domgregori/huBulb/esp8266-fastled-mqtt.ino

/*
   huBulb: https://github.com/domgregori/huBulb
   ESP8266 + FastLED + MQTT: https://github.com/jasoncoon/esp8266-fastled-webserver
   Copyright (C) 2015 Jason Coon

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
   You should have received a copy of the GNU General Public License
   along with this program.  If not, see <http://www.gnu.org/licenses/>.
*/


// TODO Flickering LED's ... https://github.com/FastLED/FastLED/issues/394 or https://github.com/FastLED/FastLED/issues/306
#define FASTLED_ALLOW_INTERRUPTS 0
#define FASTLED_ESP8266_RAW_PIN_ORDER
//#define FASTLED_INTERRUPT_RETRY_COUNT 0
#include "FastLED.h"
FASTLED_USING_NAMESPACE

extern "C" {
#include "user_interface.h"
}

#include <ESP8266WiFi.h>
#include <WiFiClient.h>
#include <EEPROM.h>
#include <PubSubClient.h>
#include <ArduinoJson.h>
#include "GradientPalettes.h"
#include "Settings.h"

CRGB leds[NUM_LEDS];

uint8_t patternIndex = 0;

const uint8_t brightnessCount = 5;
uint8_t brightnessMap[brightnessCount] = { 16, 32, 64, 128, 255 };
int brightnessIndex = 0;
uint8_t brightness = brightnessMap[brightnessIndex];

#define ARRAY_SIZE(A) (sizeof(A) / sizeof((A)[0]))

// ten seconds per color palette makes a good demo
// 20-120 is better for deployment
#define SECONDS_PER_PALETTE 10

///////////////////////////////////////////////////////////////////////

// Forward declarations of an array of cpt-city gradient palettes, and
// a count of how many there are.  The actual color palette definitions
// are at the bottom of this file.
extern const TProgmemRGBGradientPalettePtr gGradientPalettes[];
extern const uint8_t gGradientPaletteCount;

// Current palette number from the 'playlist' of color palettes
uint8_t gCurrentPaletteNumber = 0;

CRGBPalette16 gCurrentPalette( CRGB::Black);
CRGBPalette16 gTargetPalette( gGradientPalettes[0] );

uint8_t currentPatternIndex = 0; // Index number of which pattern is current
bool autoplayEnabled = false;

uint8_t autoPlayDurationSeconds = 10;
unsigned int autoPlayTimeout = 0;

uint8_t gHue = 0; // rotating "base color" used by many of the patterns

CRGB solidColor = CRGB::Black;

uint8_t power = 1;

// Mqtt Vars
WiFiClient espClient;
PubSubClient client(espClient);


typedef void (*Pattern)();
typedef Pattern PatternList[];
typedef struct {
  Pattern pattern;
  String name;
} PatternAndName;
typedef PatternAndName PatternAndNameList[];
// List of patterns to cycle through.  Each is defined as a separate function below.

#include "PatternLogics.h"

PatternAndNameList patterns = {
  { colorwaves, "Color Waves" },
  { palettetest, "Palette Test" },
  { pride, "Pride" },
  { rainbow, "Rainbow" },
  { rainbowWithGlitter, "Rainbow With Glitter" },
  { confetti, "Confetti" },
  { sinelon, "Sinelon" },
  { juggle, "Juggle" },
  { bpm, "BPM" },
  { fire, "Fire" },
  { showSolidColor, "Solid Color" },
};
const uint8_t patternCount = ARRAY_SIZE(patterns);

#include "Inits.h"

int powerFlag = 100;
int patternFlag = 100;
int brightnessFlag = 300;
int colorFlag[3] = {0,0,0};
int timer = millis();

void setup(void) {
  Serial.begin(115200);
  delay(100);
  //Serial.setDebugOutput(true);
  EEPROM.begin(512);
  loadSettings();
  initFastLED();

  logSys();

  initWlan();
  

  // Only to validate certs if u have problems ...
  // verifytls();

  //Mqtt Init
  client.setServer(mqtt_server, mqtt_port);
  client.setCallback(callback);
  autoPlayTimeout = millis() + (autoPlayDurationSeconds * 1000);
}


void callback(char* topic, byte* payload, unsigned int length) {
  char tmp[length + 1];
  strncpy(tmp, (char*)payload, length);
  tmp[length] = '\0';
  String data(tmp);

  Serial.printf("Received Data from Topic: %s ", topic);
  Serial.print(data);
  Serial.println();
  if (data.length() > 0){
    if (strcmp(topic,"huBulb/power")==0) {
      if (data == "on"){
        setPower(1);
      } else if (data == "off") {
        setPower(0);
      }
            
    } else if (strcmp(topic,"huBulb/brightness")==0) {
      setBrightness(data.toInt());
      
    } else if (strcmp(topic,"huBulb/effect")==0) {
      setPattern(data.toInt());
      
    } else if (strcmp(topic,"huBulb/color")==0) {
      String r =  getValue(data, ',', 0);
      String g =  getValue(data, ',', 1);
      String b =  getValue(data, ',', 2);
      if (r.length() > 0 && g.length() > 0 && b.length() > 0) {
        setSolidColor(r.toInt(), g.toInt(), b.toInt());
      }
    }
  }

  
}

void loop(void) {
  yield(); // Avoid crashes on ESP8266
  // Add entropy to random number generator; we use a lot of it.
  random16_add_entropy(random(65535));
  if (!client.connected()) {
    reconnectMqtt();
  }
  client.loop();



  if (power == 0) {
    fill_solid(leds, NUM_LEDS, CRGB::Black);
    FastLED.show();
    delay(15);
    return;
  }


  EVERY_N_MILLISECONDS( 20 ) {
    gHue++;  // slowly cycle the "base color" through the rainbow
  }

  // change to a new cpt-city gradient palette
  EVERY_N_SECONDS( SECONDS_PER_PALETTE ) {
    gCurrentPaletteNumber = addmod8( gCurrentPaletteNumber, 1, gGradientPaletteCount);
    gTargetPalette = gGradientPalettes[ gCurrentPaletteNumber ];
  }

  // slowly blend the current cpt-city gradient palette to the next
  EVERY_N_MILLISECONDS(40) {
    nblendPaletteTowardPalette( gCurrentPalette, gTargetPalette, 16);
  }

  if (autoplayEnabled && millis() > autoPlayTimeout) {
    adjustPattern(true);
    autoPlayTimeout = millis() + (autoPlayDurationSeconds * 1000);
  }

  // Call the current pattern function once, updating the 'leds' array
  patterns[currentPatternIndex].pattern();

  FastLED.show();
  
  if ((powerFlag != EEPROM.read(5)) || (brightnessFlag != EEPROM.read(0)) || (patternFlag != EEPROM.read(1)) || (colorFlag[0] != EEPROM.read(2)) || (colorFlag[1] != EEPROM.read(3)) || (colorFlag[2] != EEPROM.read(4)) || (millis() - timer >= 5000)) {
    StaticJsonDocument<200> jsonBuffer;
    JsonObject json = jsonBuffer.to<JsonObject>();
    json["status"] = "online";
    if (EEPROM.read(5) == 1) {
      json["power"] = "on";
    } else {
      json["power"] = "off";
    }    
    json["brightness"] = EEPROM.read(0);
    json["pattern"] = EEPROM.read(1);
    JsonArray colorJ = json.createNestedArray("color");
    json["color"].add(EEPROM.read(2));
    json["color"].add(EEPROM.read(3));
    json["color"].add(EEPROM.read(4));
    char buff[200];
    serializeJson(json, buff);

    Serial.println(buff);
    
    if (client.publish("huBulb/status", buff, true) == false) {
      Serial.println("Error publishing status");
    }

    json.clear();

    powerFlag = EEPROM.read(5);
    brightnessFlag = EEPROM.read(0);
    patternFlag = EEPROM.read(1);
    colorFlag[0] = EEPROM.read(2);
    colorFlag[1] = EEPROM.read(3);
    colorFlag[2] = EEPROM.read(4);
    timer = millis();
  }
  

  // insert a delay to keep the framerate modest
  delay(1000 / FRAMES_PER_SECOND);
}


void reconnectMqtt() {
  while (!client.connected()) {
    Serial.println("Attempting MQTT connection...");
    if (client.connect(mqtt_clientid, mqtt_user, mqtt_password, "huBulb/status", 1, 0, "{\"status\":\"offline\"}")) {
      Serial.println("connected");
      client.subscribe("huBulb/power");
      client.subscribe("huBulb/brightness");
      client.subscribe("huBulb/effect");
      client.subscribe("huBulb/color");
    } else {
      Serial.print("failed, rc=");
      Serial.print(client.state());
      Serial.println(" try again in 5 seconds");
      // Wait 5 seconds before retrying
      delay(5000);
    }
  }
}


void setPower(uint8_t value)
{
  power = value == 0 ? 0 : 1;
  if (power == 0) {
    Serial.println("{\"power\":\"off\"}");
    if (client.publish("huBulb/status", "{\"power\":\"off\"}", true) == false) {
      Serial.println("Error publishing power");
    }
  }
  EEPROM.write(5, power);
  EEPROM.commit();
  
}

void setSolidColor(CRGB color)
{
  setSolidColor(color.r, color.g, color.b);
}

void setSolidColor(uint8_t r, uint8_t g, uint8_t b)
{
  solidColor = CRGB(r, g, b);

  EEPROM.write(2, r);
  EEPROM.write(3, g);
  EEPROM.write(4, b);

  setPattern(patternCount - 1);
}

// increase or decrease the current pattern number, and wrap around at theends
void adjustPattern(bool up)
{
  if (up)
    currentPatternIndex++;
  else
    currentPatternIndex--;

  // wrap around at the ends
  if (currentPatternIndex < 0)
    currentPatternIndex = patternCount - 1;
  if (currentPatternIndex >= patternCount)
    currentPatternIndex = 0;

  EEPROM.write(1, currentPatternIndex);
  EEPROM.commit();
}

void setPattern(int value)
{
  // don't wrap around at the ends
  if (value < 0)
    value = 0;
  else if (value >= patternCount)
    value = patternCount - 1;

  currentPatternIndex = value;

  EEPROM.write(1, currentPatternIndex);
  EEPROM.commit();
}

// adjust the brightness, and wrap around at the ends
void adjustBrightness(bool up)
{
  if (up)
    brightnessIndex++;
  else
    brightnessIndex--;

  // wrap around at the ends
  if (brightnessIndex < 0)
    brightnessIndex = brightnessCount - 1;
  else if (brightnessIndex >= brightnessCount)
    brightnessIndex = 0;

  brightness = brightnessMap[brightnessIndex];

  FastLED.setBrightness(brightness);

  EEPROM.write(0, brightness);
  EEPROM.commit();
}

void setBrightness(int value)
{
  // don't wrap around at the ends
  if (value > 255)
    value = 255;
  else if (value < 0) value = 0;

  brightness = value;

  FastLED.setBrightness(brightness);

  EEPROM.write(0, brightness);
  EEPROM.commit();
}

String getValue(String data, char separator, int index)
{
  int found = 0;
  int strIndex[] = { 0, -1 };
  int maxIndex = data.length() - 1;

  for (int i = 0; i <= maxIndex && found <= index; i++) {
    if (data.charAt(i) == separator || i == maxIndex) {
      found++;
      strIndex[0] = strIndex[1] + 1;
      strIndex[1] = (i == maxIndex) ? i + 1 : i;
    }
  }
  return found > index ? data.substring(strIndex[0], strIndex[1]) : "";
}


boolean isValidNumber(String str) {
  // TODO replace with regex check
  bool result = false;
  for (byte i = 0; i < str.length(); i++)
  {
    if (isDigit(str.charAt(i))) {
      result = true;
    } else {
      result = false;
      break;
    }
  }
  return result;
}
